turingbirds/undervoltage_lockout/uvlo_schematic.pdf

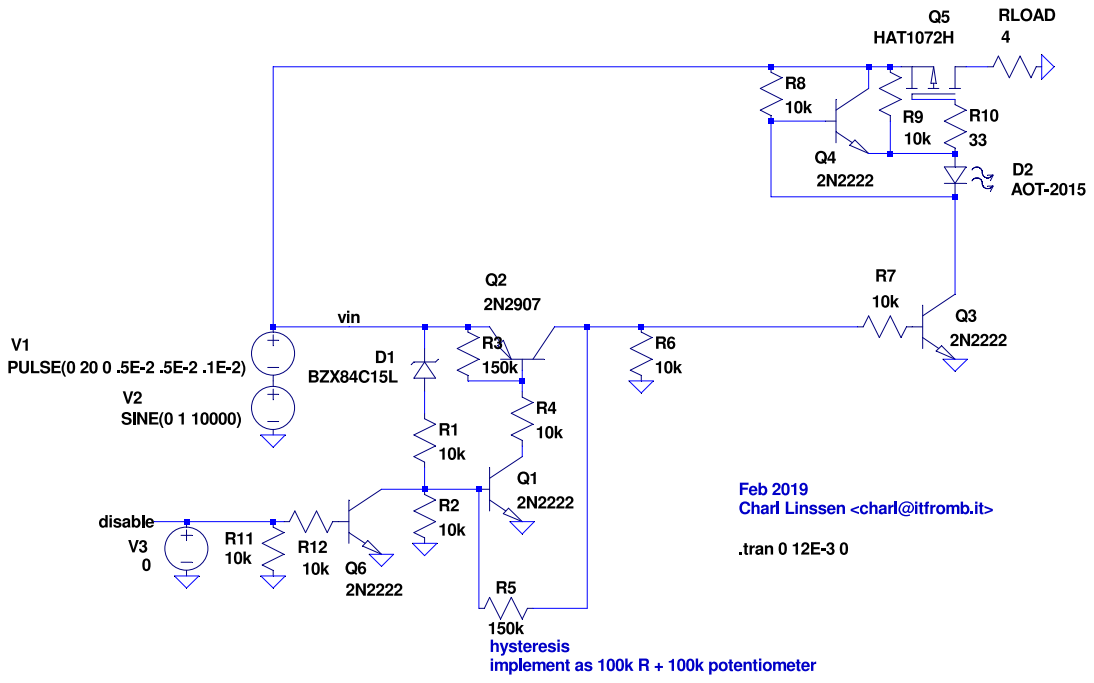
[picture p2: page 1]
