turingbirds/undervoltage_lockout/uvlo_circuit_ltspice.asc

D1: zener; BZX84C15L
D2: LED; AOT-2015
Q1: npn; 2N2222
Q2: pnp; 2N2907
Q3: npn; 2N2222
Q4: npn; 2N2222
Q5: pmos; HAT1072H
Q6: npn; 2N2222
R1: res; 10k
R2: res; 10k
R3: res; 150k
R4: res; 10k
R5: res; 150k
R6: res; 10k
R7: res; 10k
R8: res; 10k
R9: res; 10k
R10: res; 33
R11: res; 10k
R12: res; 10k
RLOAD: res; 4
V1: voltage; PULSE(0 20 0 .5E-2 .5E-2 .1E-2)
V2: voltage; SINE(0 1 10000)
V3: voltage; 0
Named nets: 0, vin, disable
.tran 0 12E-3 0
hysteresis
implement as 100k R + 100k potentiometer
Feb 2019
Charl Linssen <charl@itfromb.it>
