turingbirds/undervoltage_lockout/(commit log)

2019-02-22 update README; add schematic and waveforms
2019-02-22 add ltspice schematic entry
2019-02-22 add link to LTspice schematic in README
2019-02-22 prettified schematic
